santiagoenriquez15/Prototipo-Educativo-Brazo-Robotico/imagenes/Foto real brazo robotico 2.jpeg

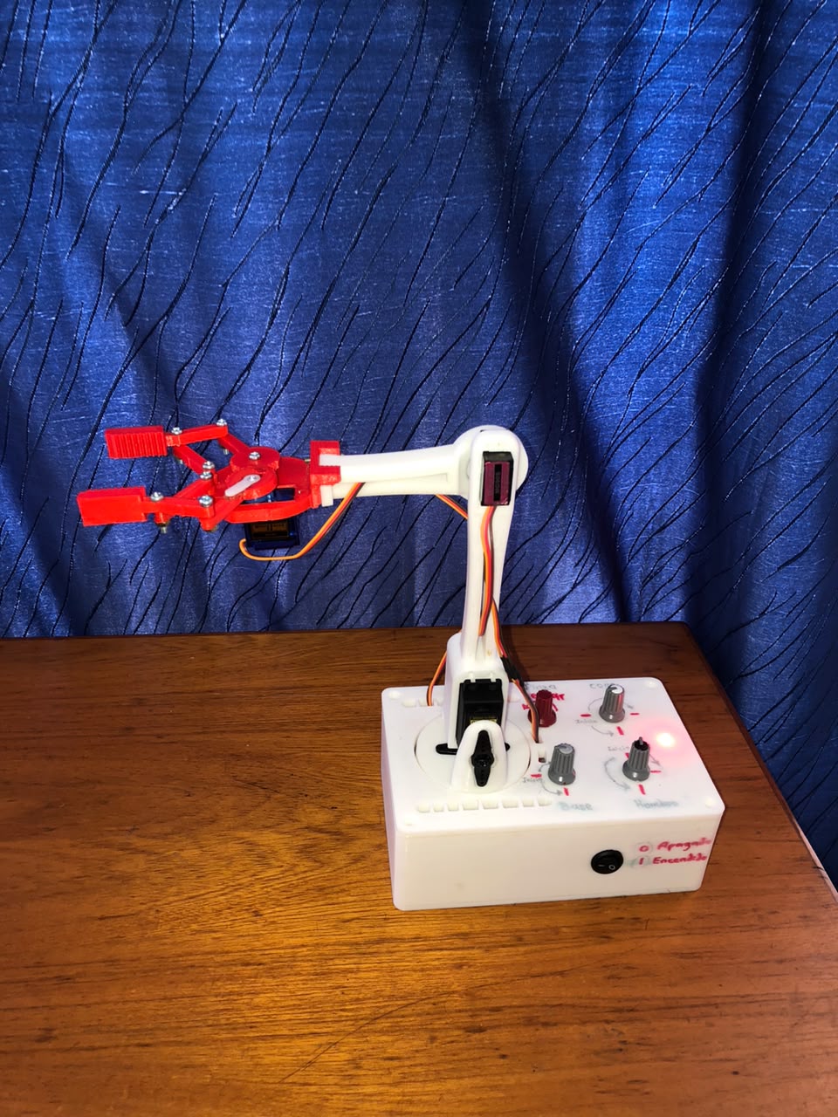
imagenes/Foto real brazo robotico 2.jpeg
