santiagoenriquez15/Prototipo-Educativo-Brazo-Robotico/imagenes/prototipo_impreso.jpg

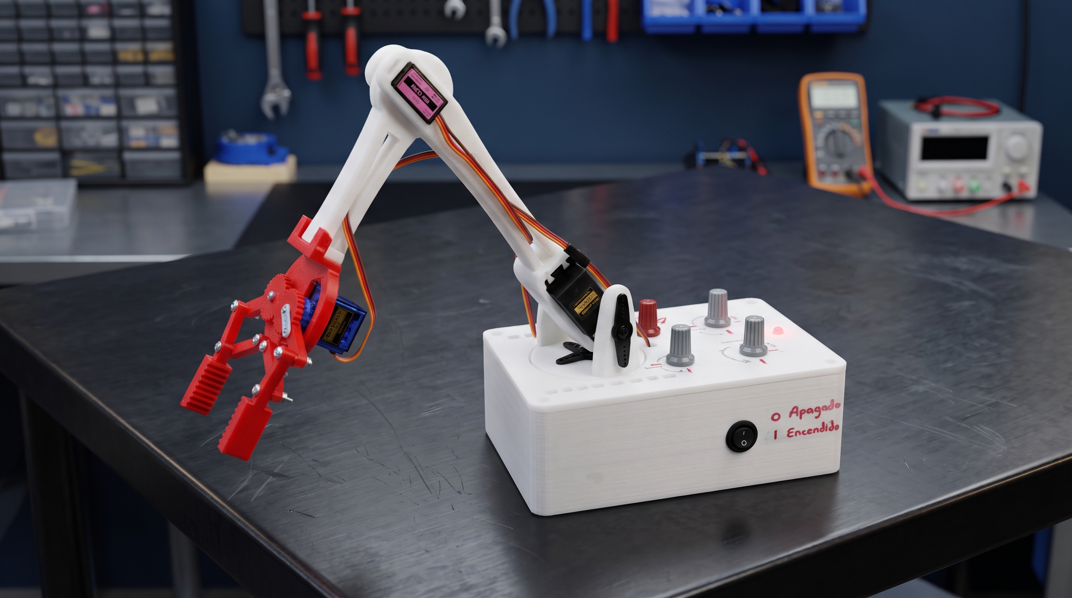
imagenes/prototipo_impreso.jpg
