santiagoenriquez15/Prototipo-Educativo-Brazo-Robotico/cartilla/Cartilla_Brazo_Robotico.pdf

# CCAARRTTIILLLLAA

# EEDDUUCCAATTIIVVAA

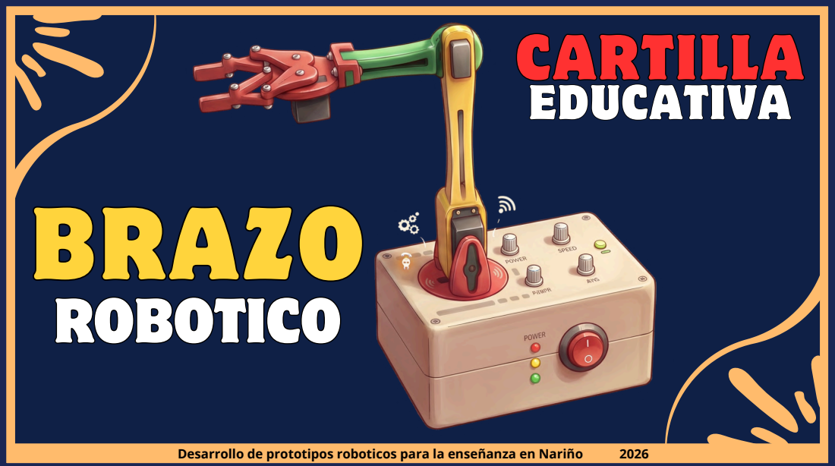
[picture p3: page 1]
Desarrollo de prototipos roboticos para la enseñanza en Nariño; RROOBBOOTTIICCOO; BRAZO

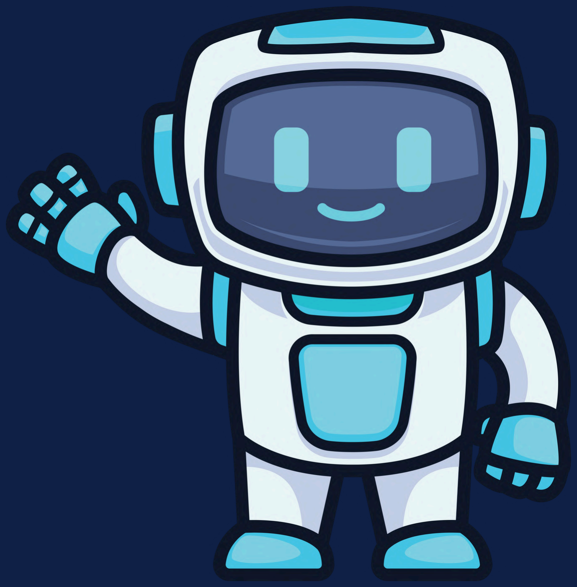
[picture p4: figure]

Desarrollo de Prototipos Robóticos Educativos para la enseñanza en Nariño.

### TABLA DE CONTENIDO

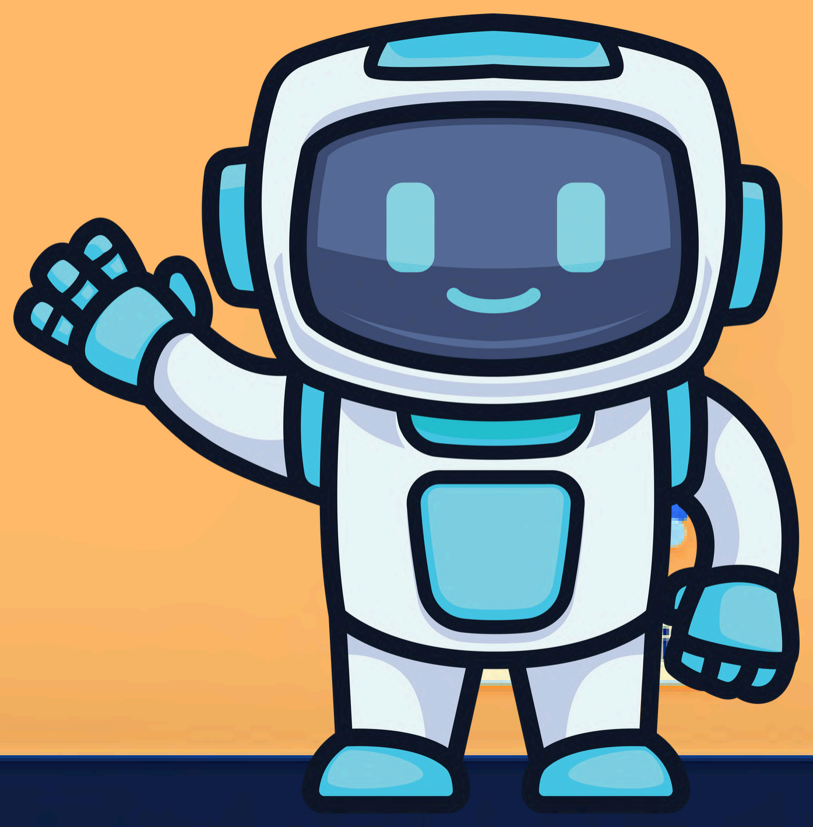
[picture p5: figure]

## FUNDAMENTOS TEORICOS:

Introduccion a la robotica, desarrollo de habilidades STEM, cinematica y grados de libertad.

## PIEZAS Y COMPONENTES :

Imagenes de piezas 3D,componentes electronicos, tornilleria.

## ELECTRÓNICA, PROGRAMACIÓN Y GESTIÓN ENERGÉTICA:

Indicador nivel de bateria, codigo de programacion arduino, circuito electronico.
INSTRUCCIONES DE EMSAMBLAJE PASO A PASO.
Hombro y codo, pinza, caja base y acope final.

## RECOMENDACIONES DE USO Y CRÉDITOS DEL PROYECTO

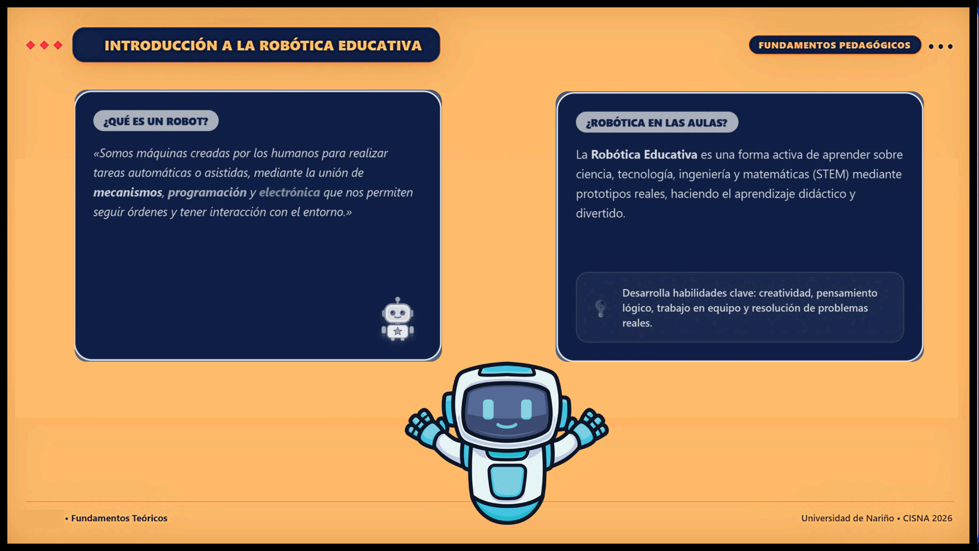
[picture p6: page 4]
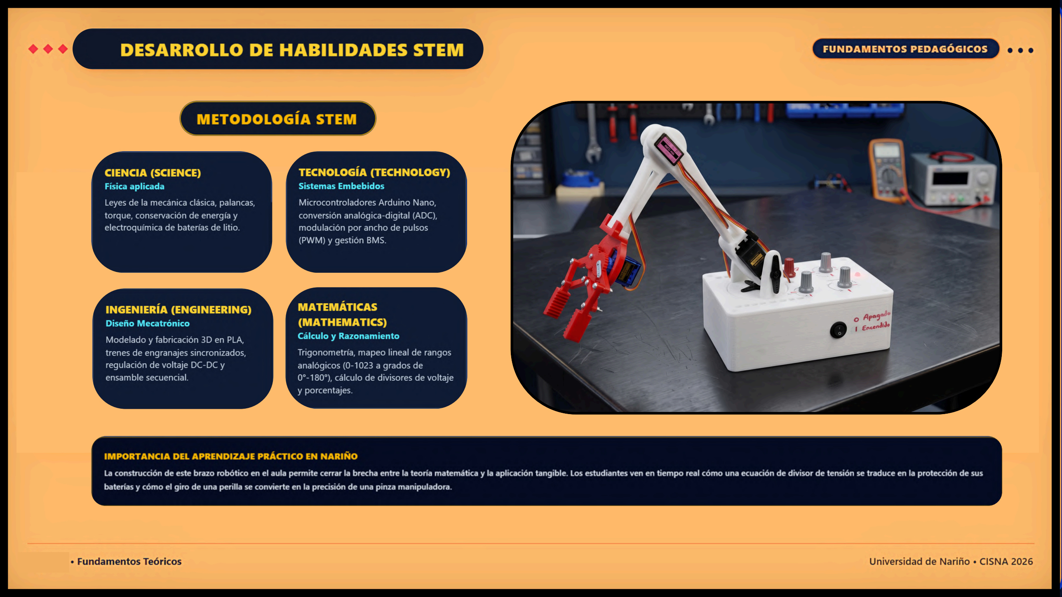
[picture p7: page 5]
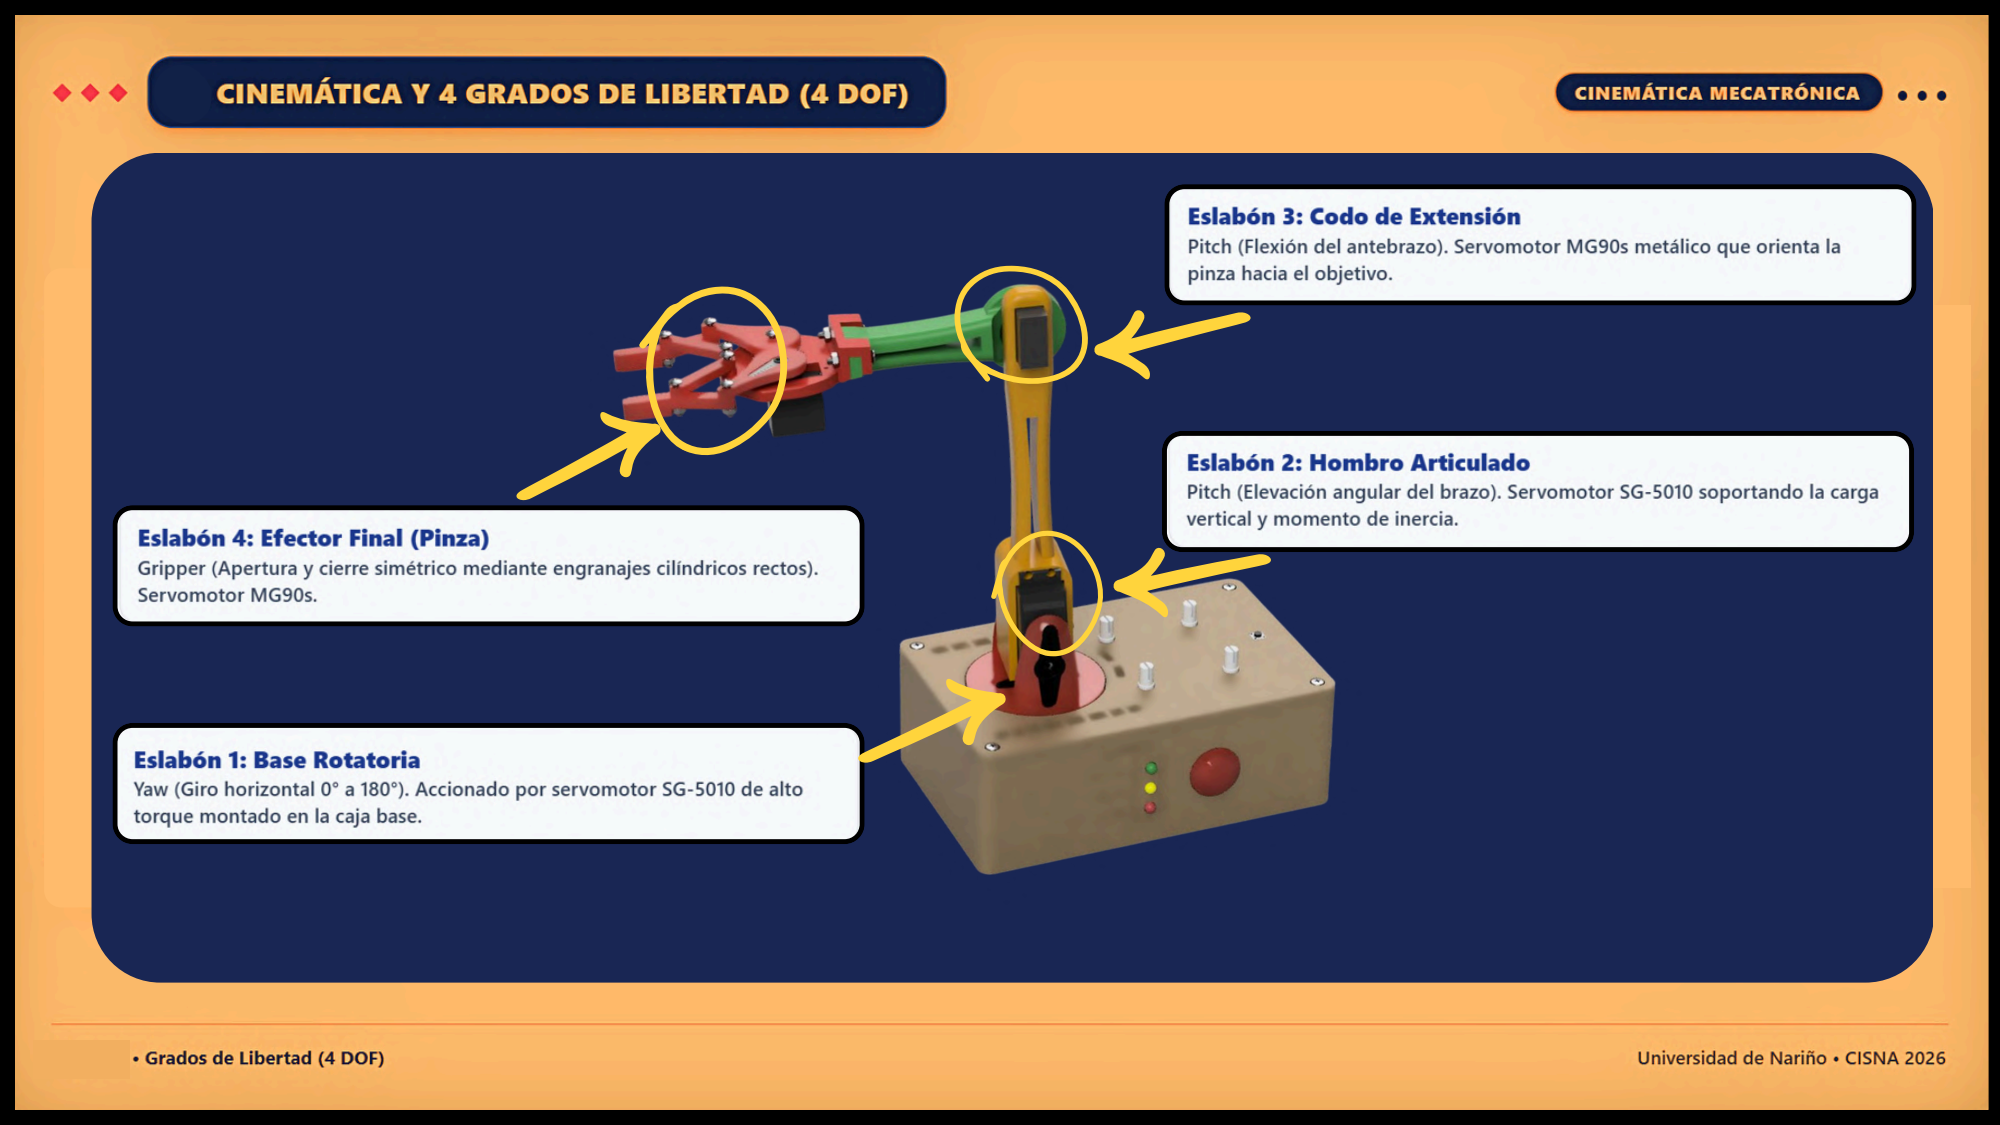
[picture p8: page 6]

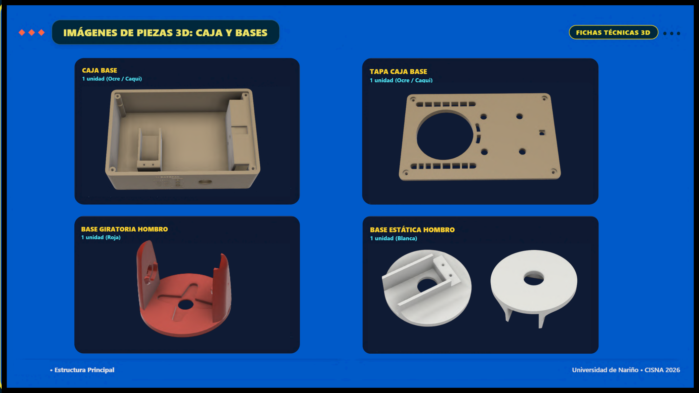
[picture p9: page 7]
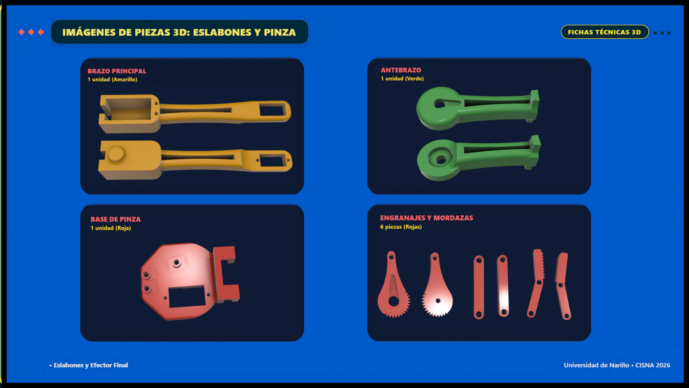
[picture p10: page 8]
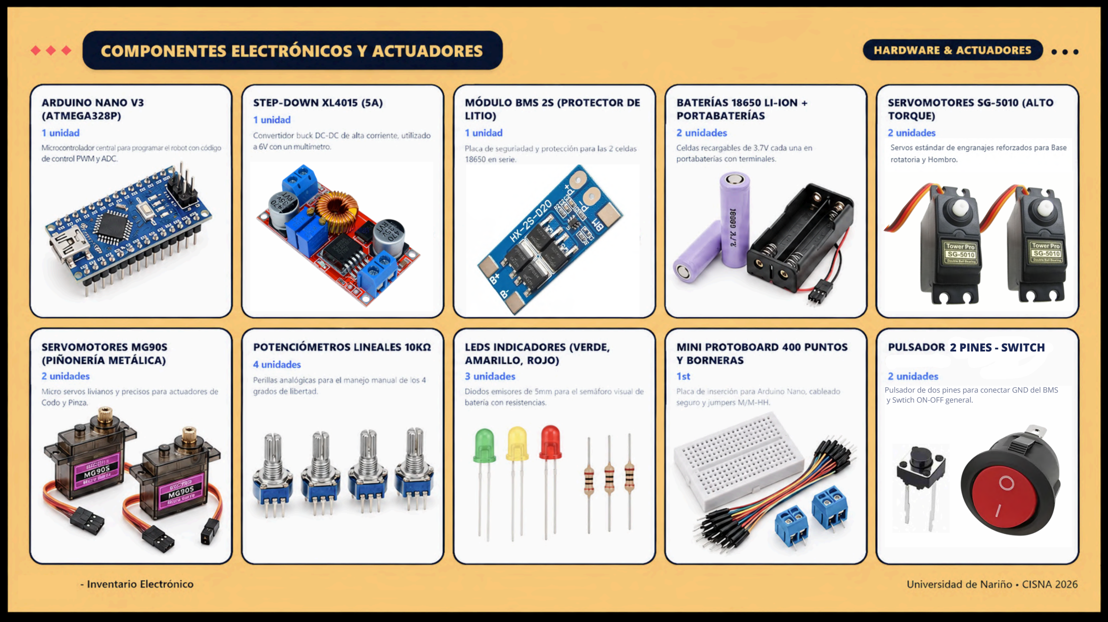
[picture p11: page 9]

### 2 PINES - SWITCH

Pulsador de dos pines para conectar GND del BMS y Swtich ON-OFF general.

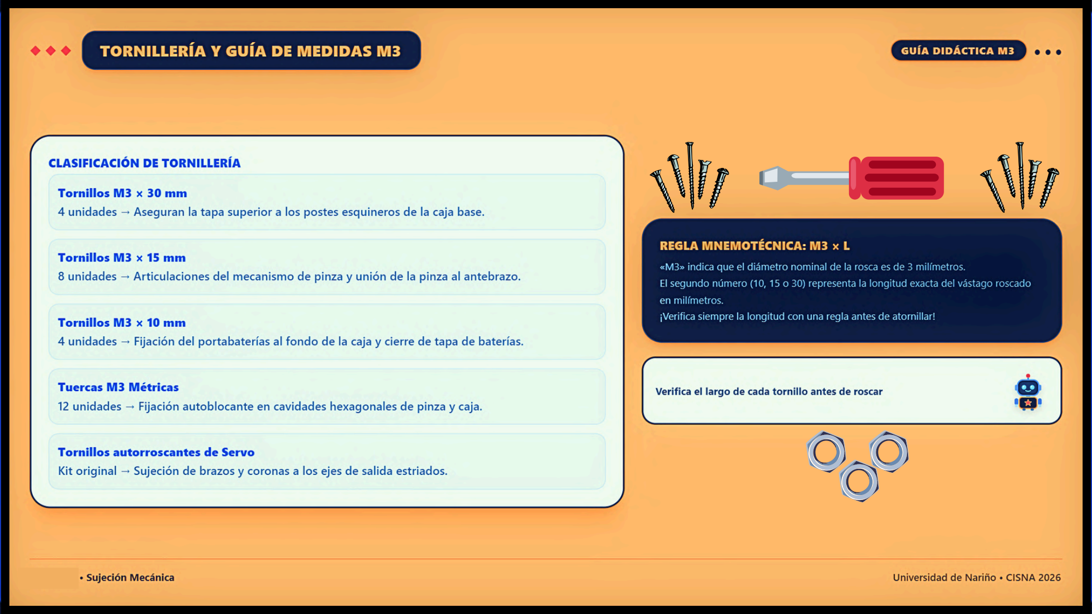
[picture p12: page 10]

6.6v - 7.3v

7.8v-8.4v

7.3v - 7.8v

4.7kΩ

2.4kΩ

(2.4/7.1) 2.84v

El sistema para estimar el porcentaje de carga de las baterías del prototipo se implementó mediante la lectura del voltaje a través de una entrada analógica del Arduino Nano. Para ello, se utilizó un divisor de voltaje con resistencias, que permite reducir la tensión de la batería a un nivel seguro para el microcontrolador. A partir de esta lectura, se calcula un porcentaje aproximado de carga, el cual se representa visualmente mediante tres LED indicadores: verde, amarillo y rojo, que permiten identificar el estado de la batería.

# Diagrama del codigo

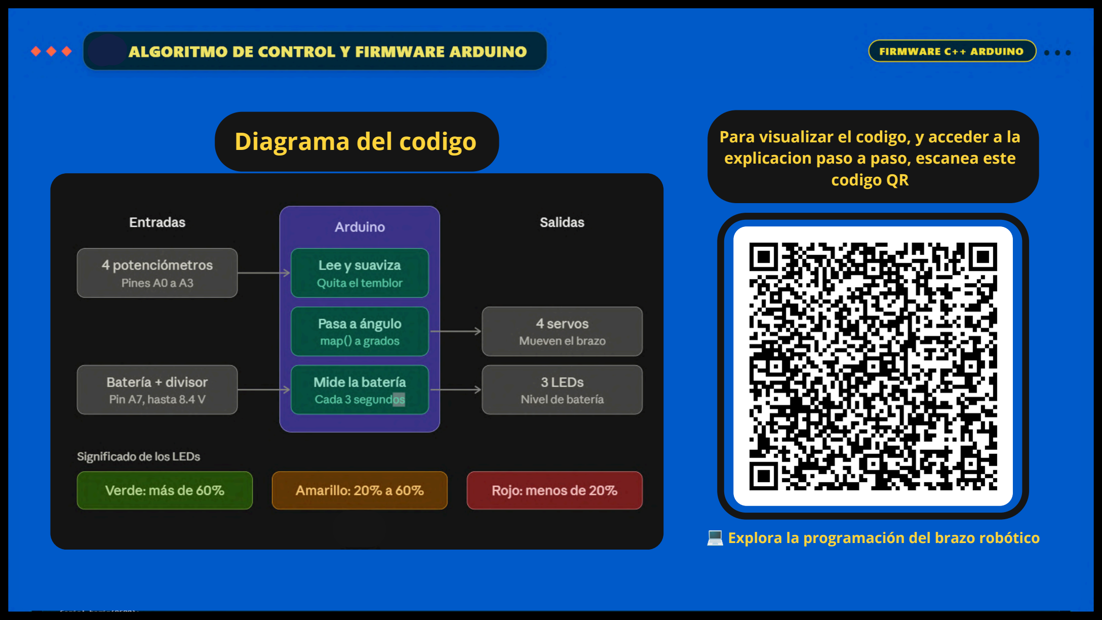
[picture p13: page 12]

Para visualizar el codigo, y acceder a la explicacion paso a paso, escanea este codigo QR

💻 Explora la programación del brazo robótico

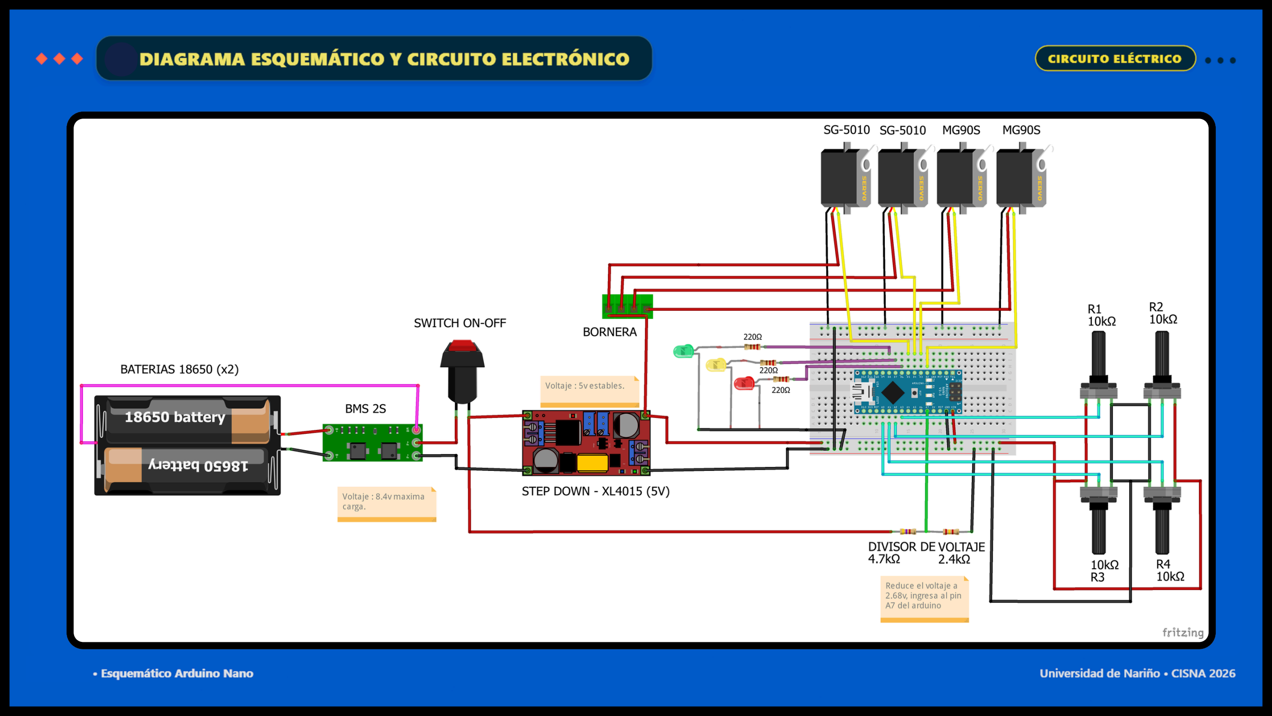
[picture p14: page 13]
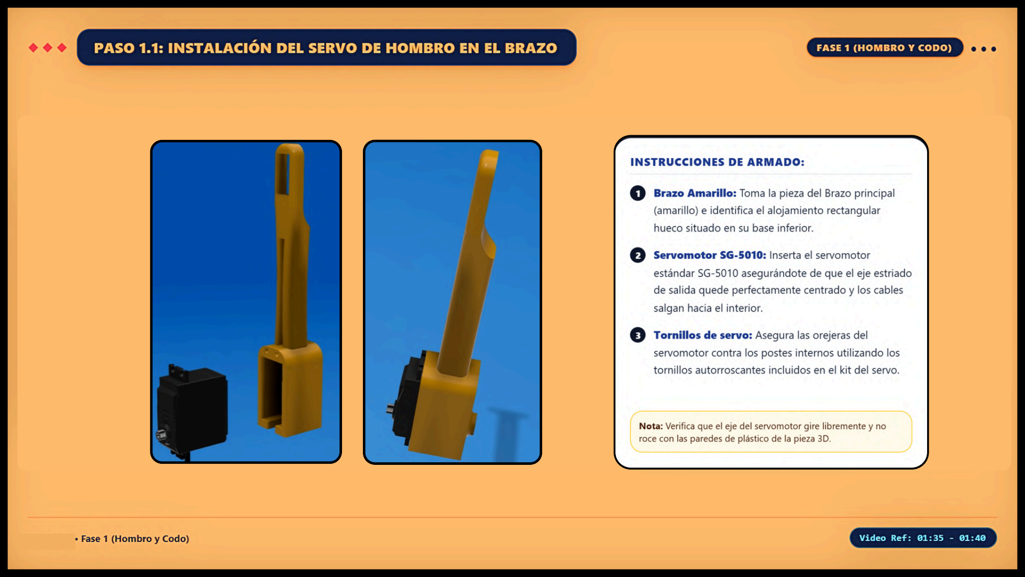
[picture p15: page 14]
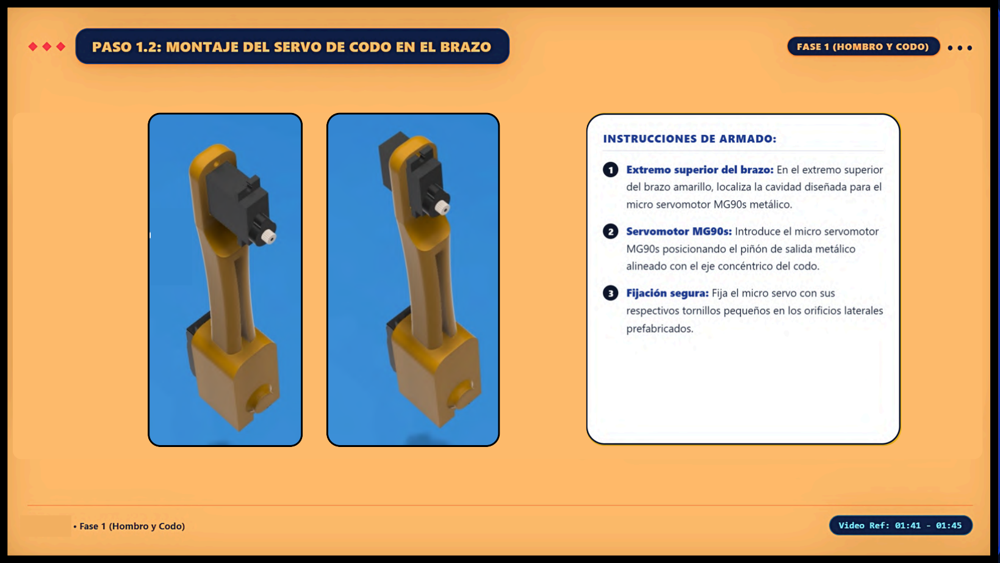
[picture p16: page 15]
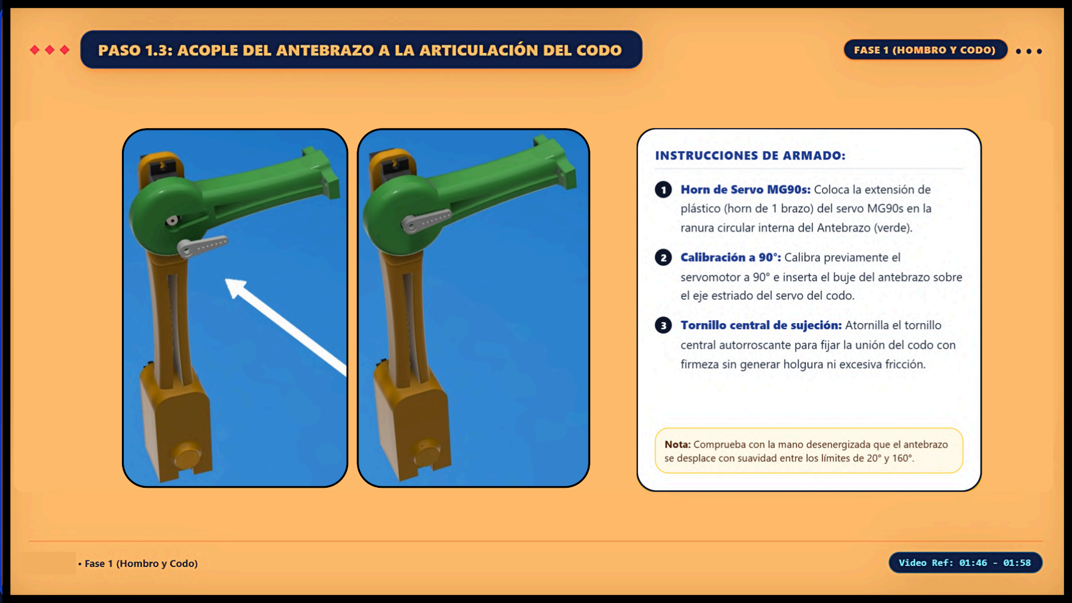
[picture p17: page 16]
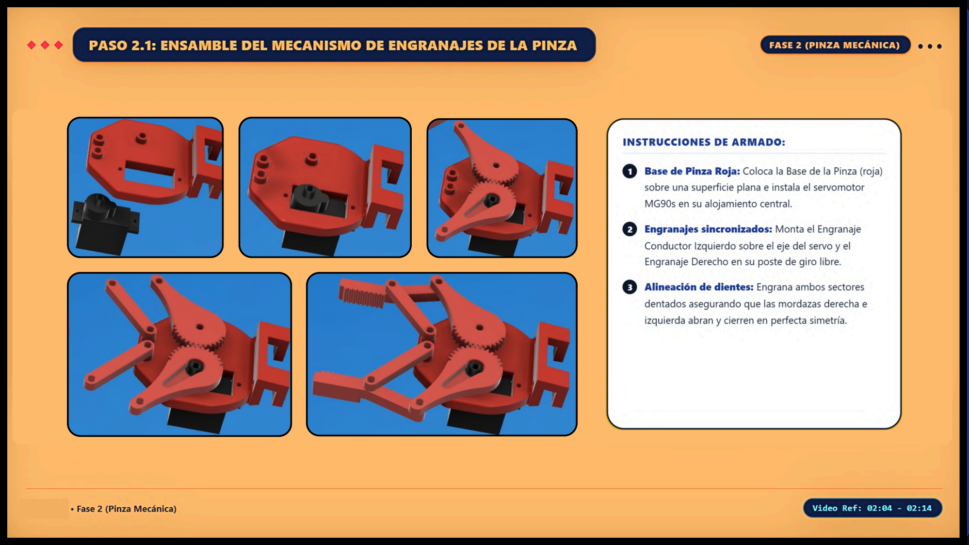
[picture p18: page 17]
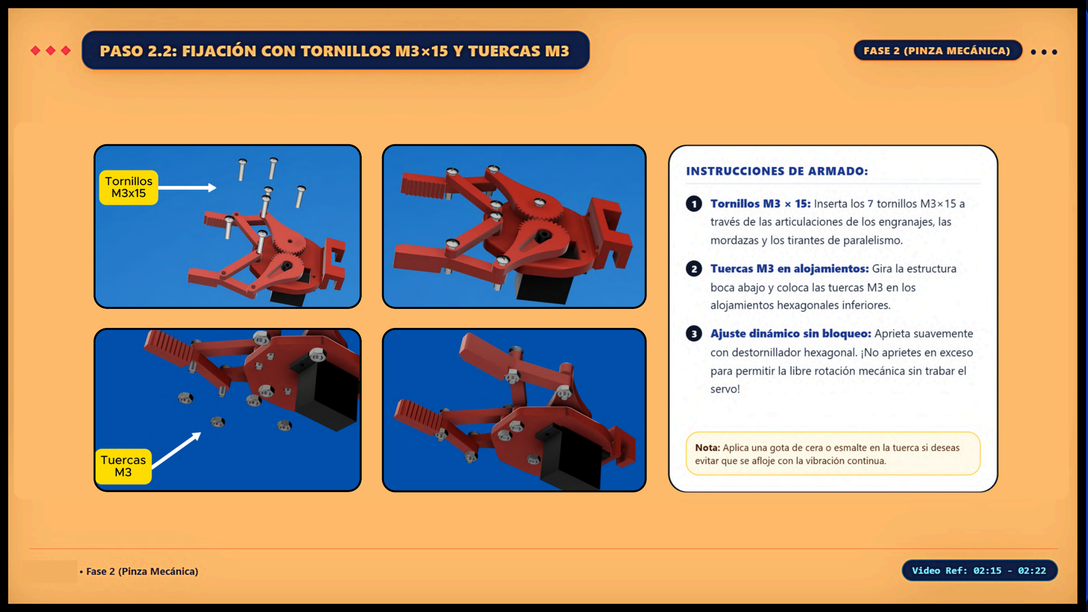
[picture p19: page 18]

7

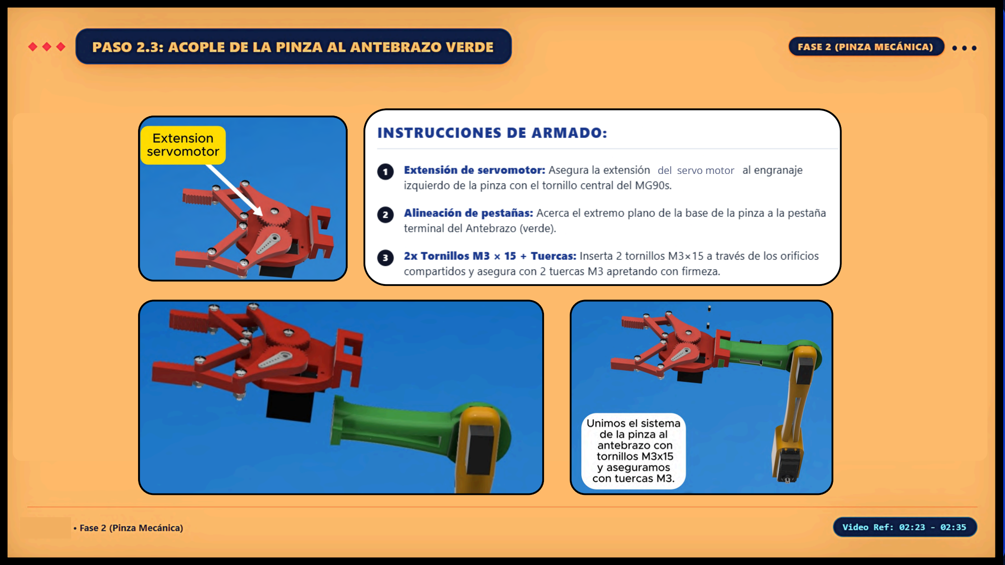
[picture p20: page 19]

del servo motor

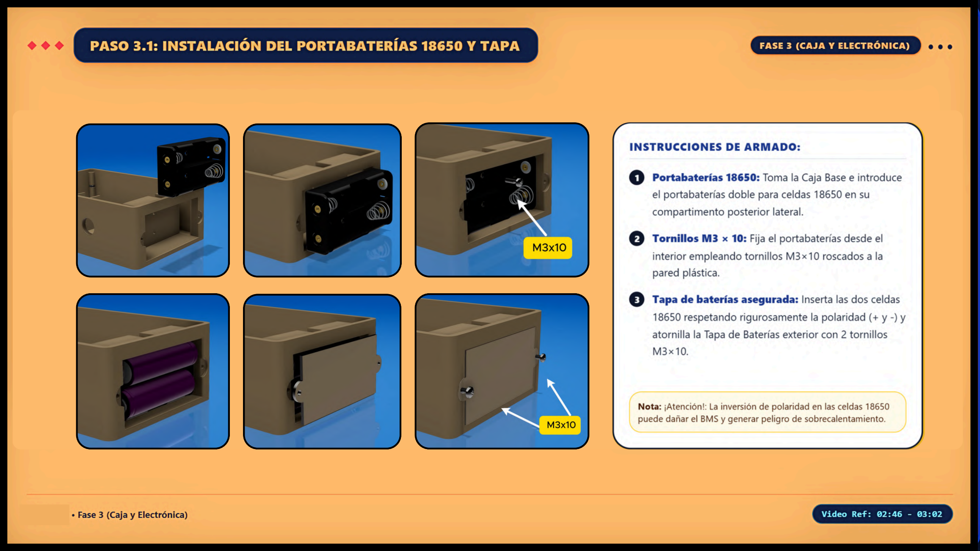
[picture p21: page 20]
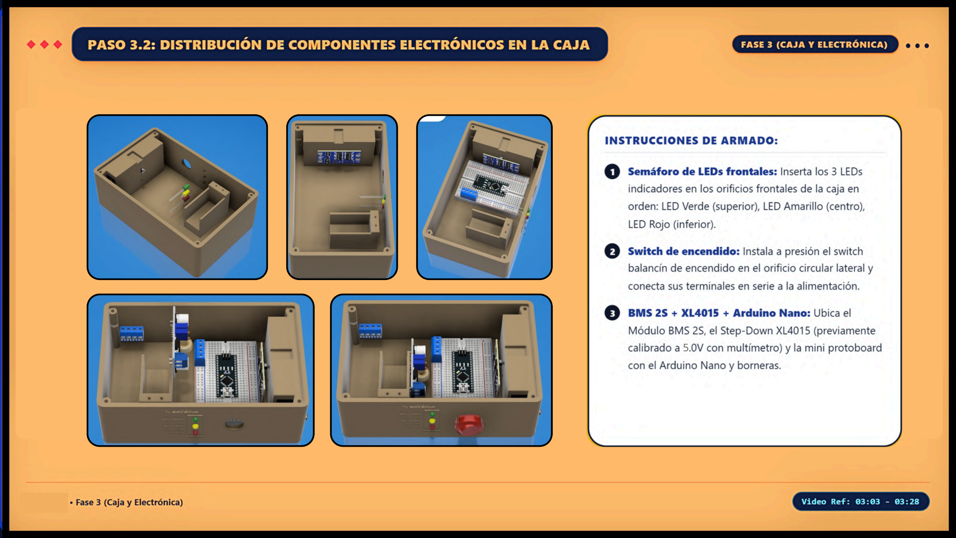
[picture p22: page 21]

5

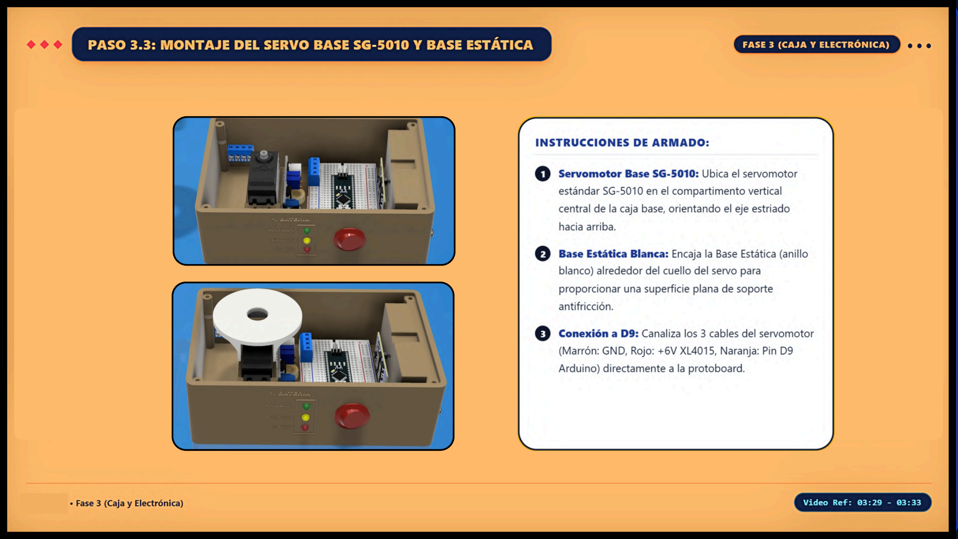
[picture p23: page 22]
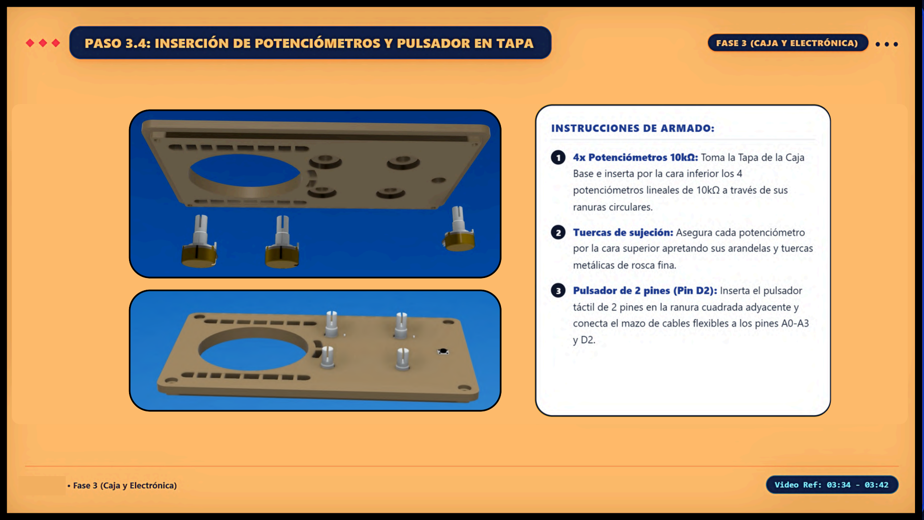
[picture p24: page 23]
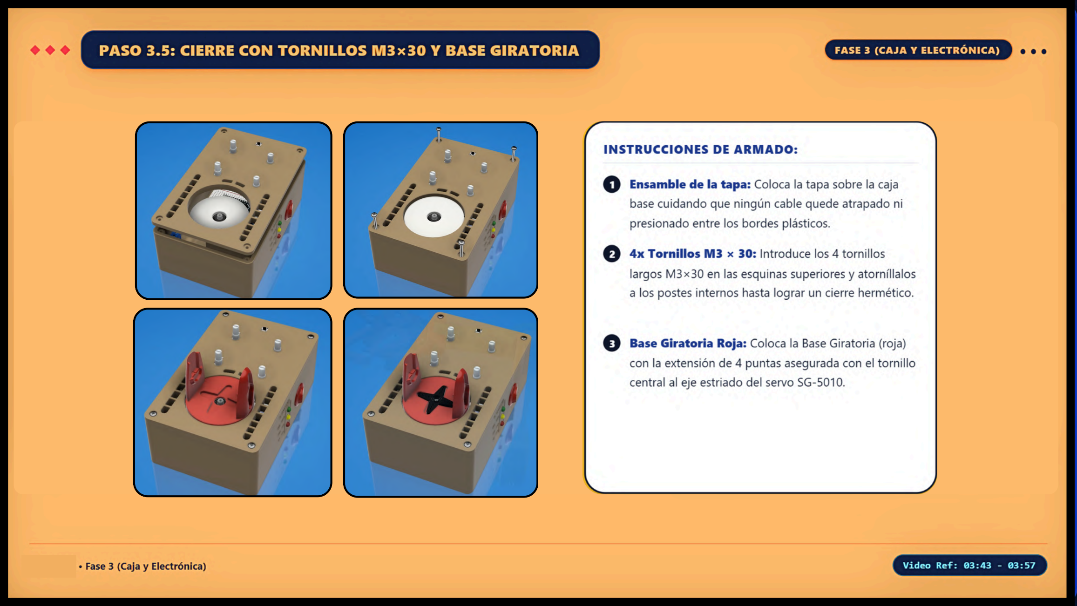
[picture p25: page 24]
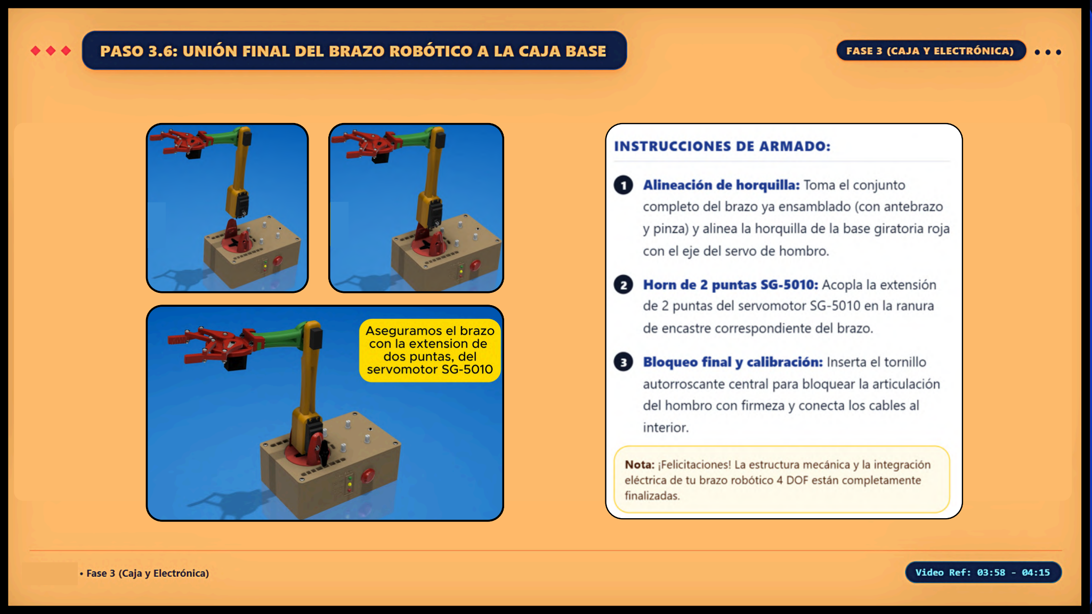
[picture p26: page 25]

Prototipo Renderizado | Prototipo Real

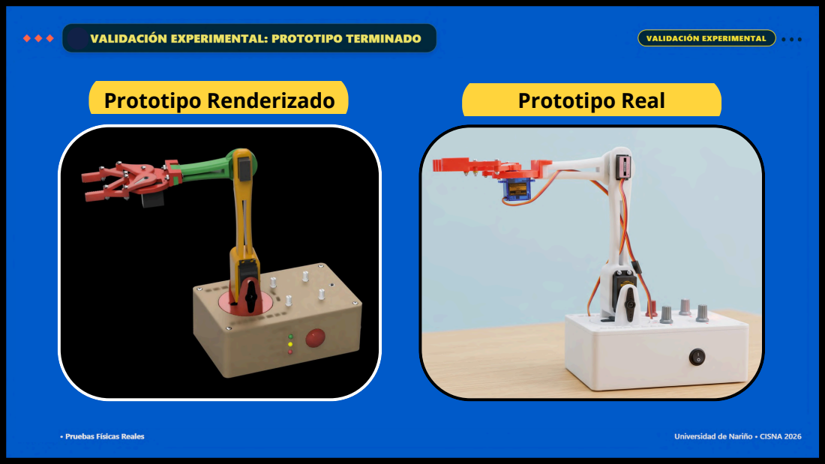
[picture p27: page 26]

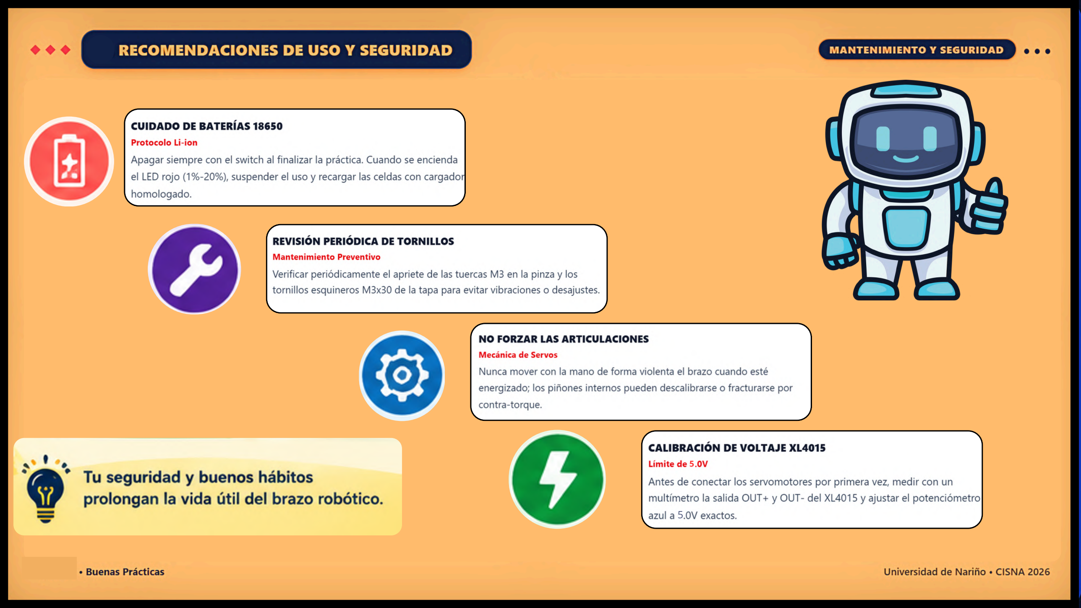
[picture p28: page 27]

5

5
