santiagoenriquez15/Prototipo-Educativo-Brazo-Robotico/circuito/Circuito Brazo Robotico_final.png

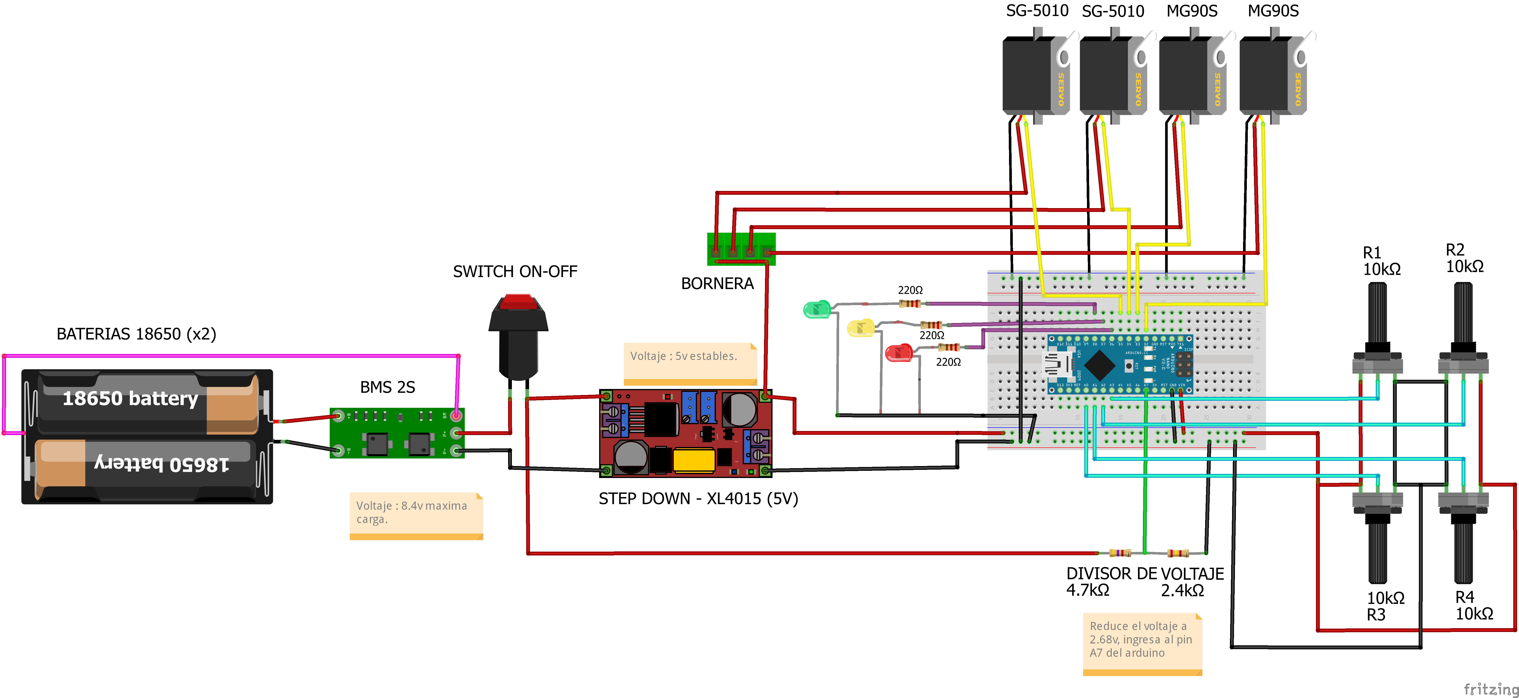
circuito/Circuito Brazo Robotico_final.png
