santiagoenriquez15/Prototipo-Educativo-Brazo-Robotico/imagenes/render brazo robotico.jpg

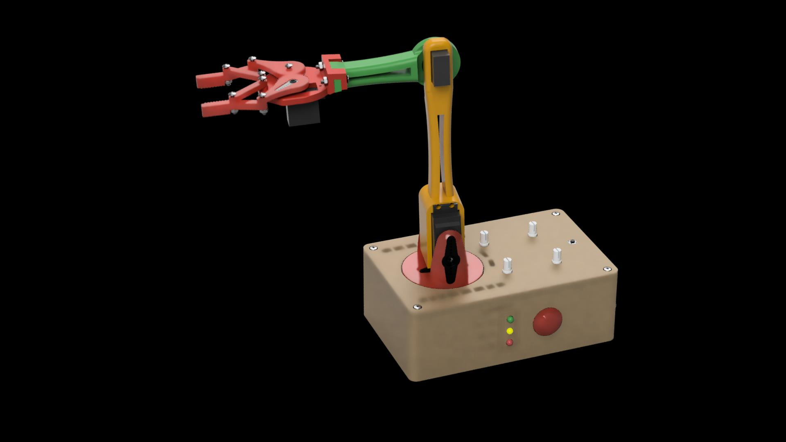
imagenes/render brazo robotico.jpg
