santiagoenriquez15/Prototipo-Educativo-Brazo-Robotico/Imagen_listado_componentes_brazo_robotico.png

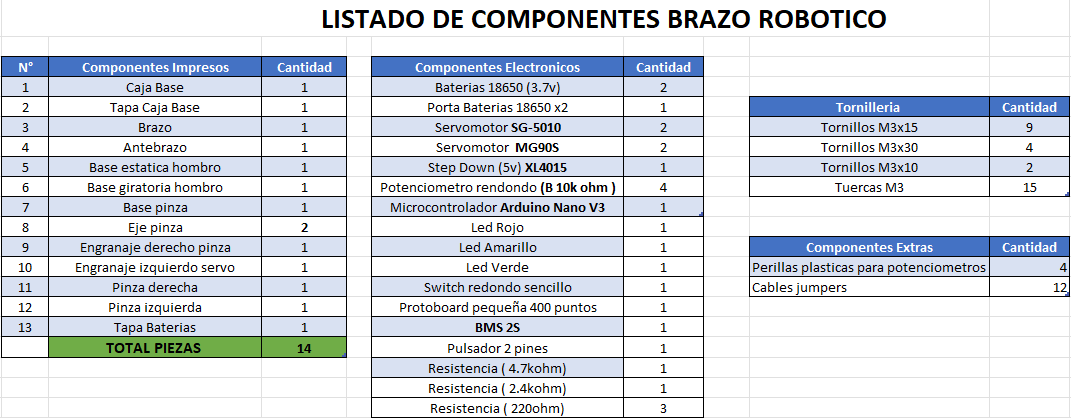
Imagen_listado_componentes_brazo_robotico.png
