santiagoenriquez15/Prototipo-Educativo-Brazo-Robotico/(commit log)

2026-10-16 Create Codigo_brazo_robotico
    Creacion de carpeta codigo
2026-10-16 Circuito Brazo Robotico_final.png
2026-10-17 Add files via upload
    Explicacion del codigo para programar el brazo robotico, dividido por bloques para mejor entendimiento.
2026-10-17 Add files via upload
    Se sube cartilla de manual de armado del prototipo brazo robotico
2026-10-17 Archivos STL Brazo Robotico.zip
2026-10-17 Add files via upload
    Subida de piezas STL del brazo robotico para imprimir
2026-10-20 Create Circuito Brazo Robotico_final.png
    Se añade diagrama del circuito
2026-10-20 Add files via upload
    Listado de componentes
2026-10-20 Actualiza recursos del brazo y añade tutorial de armado en YouTube
2026-10-20 Reorganiza video demostrativo y simplifica bloques de recursos
2026-10-20 Mejora imagen principal y botones del bloque de programación
